robin-eckert/rump/circuit/ibm1394312/bottom_copper.png

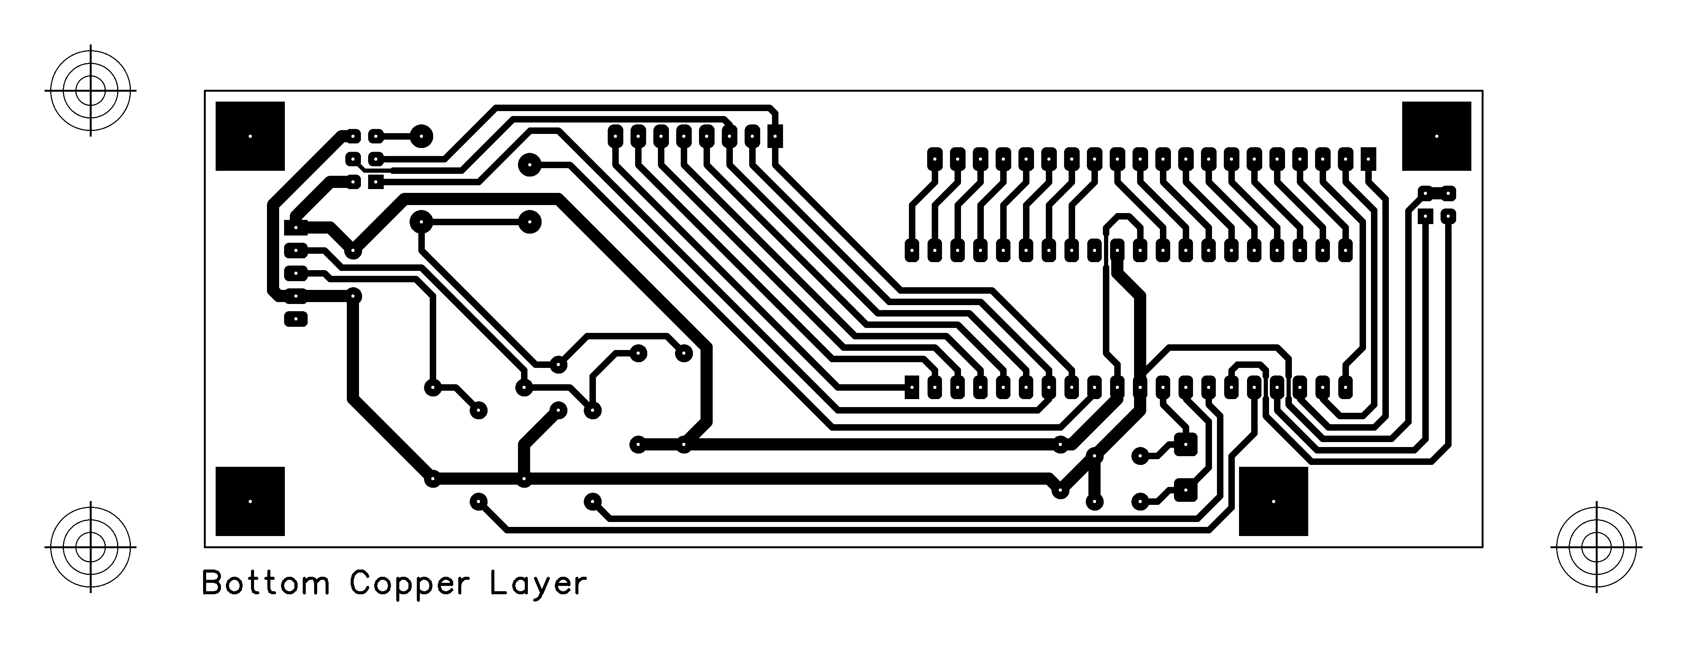
circuit/ibm1394312/bottom_copper.png
