robin-eckert/rump/circuit/ibm1394312/schematic.png

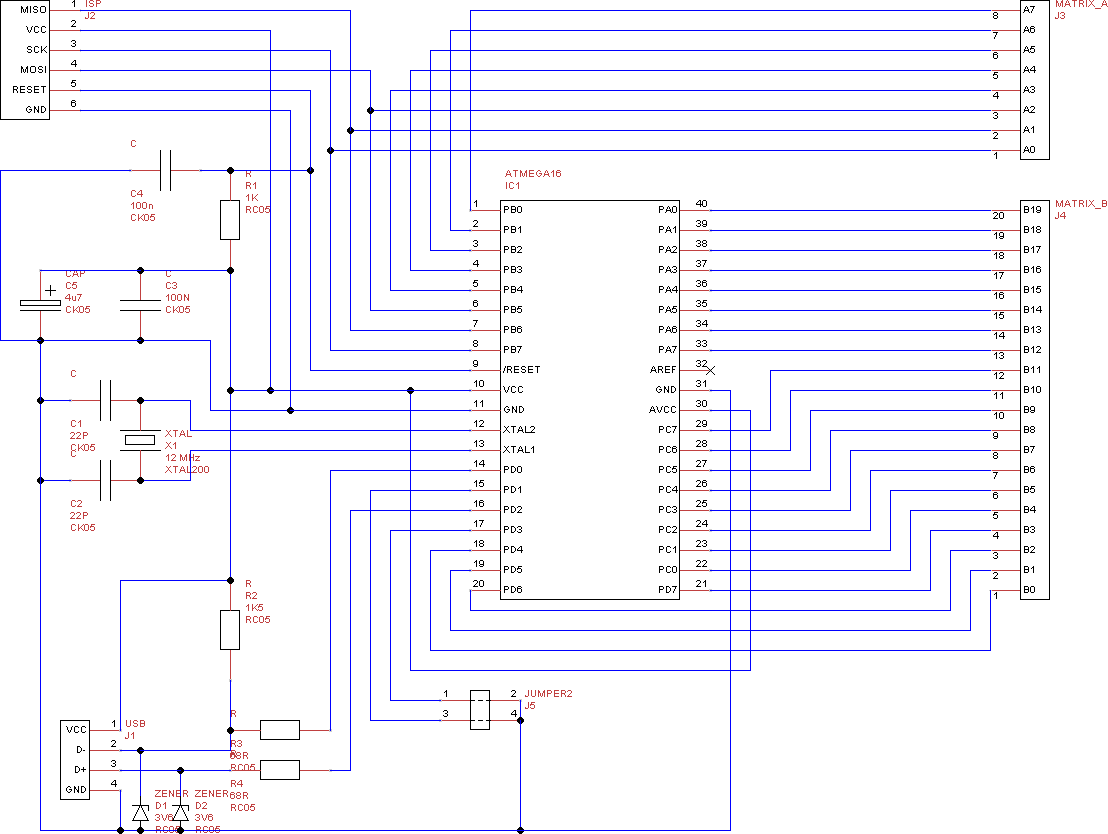
circuit/ibm1394312/schematic.png
