robin-eckert/rump/circuit/ibm1394312/top_copper.png

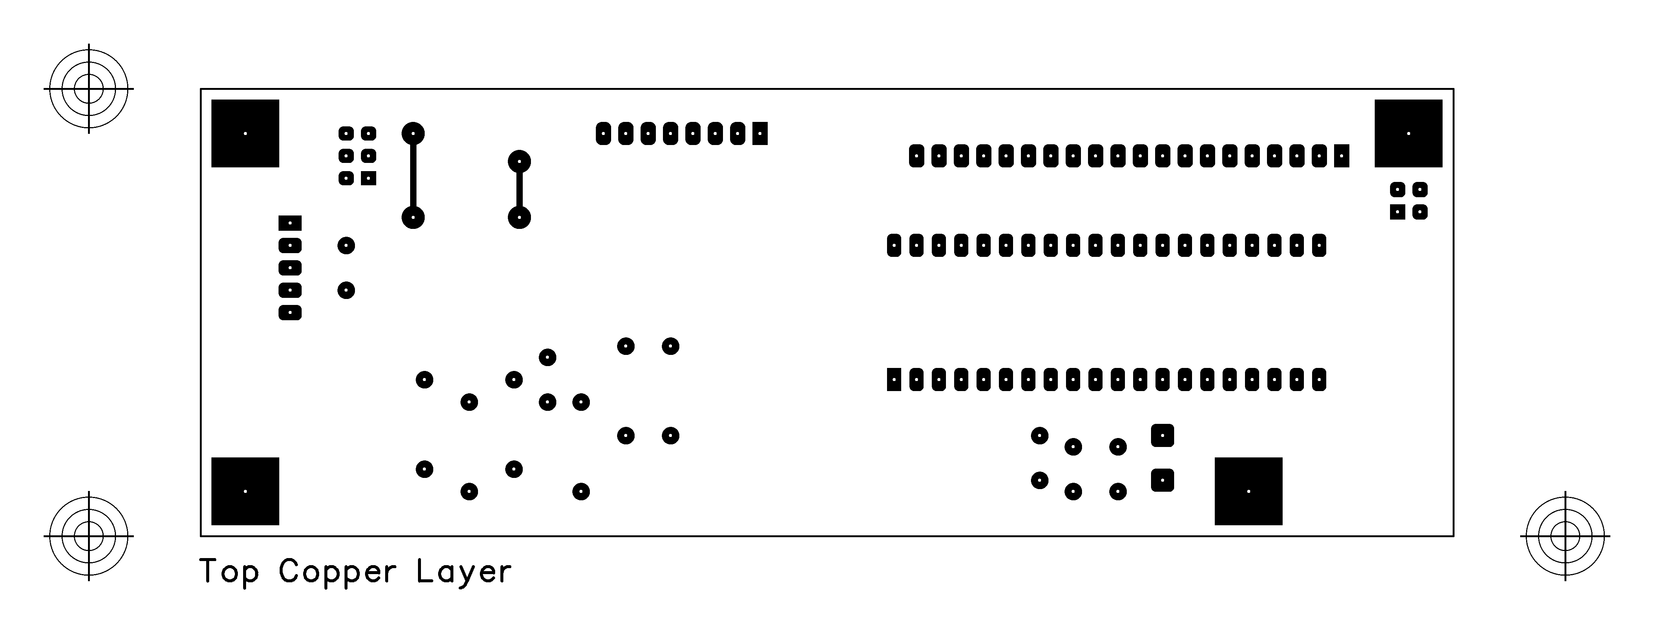
circuit/ibm1394312/top_copper.png
