robin-eckert/rump/circuit/ibm1394312/top_silk.png

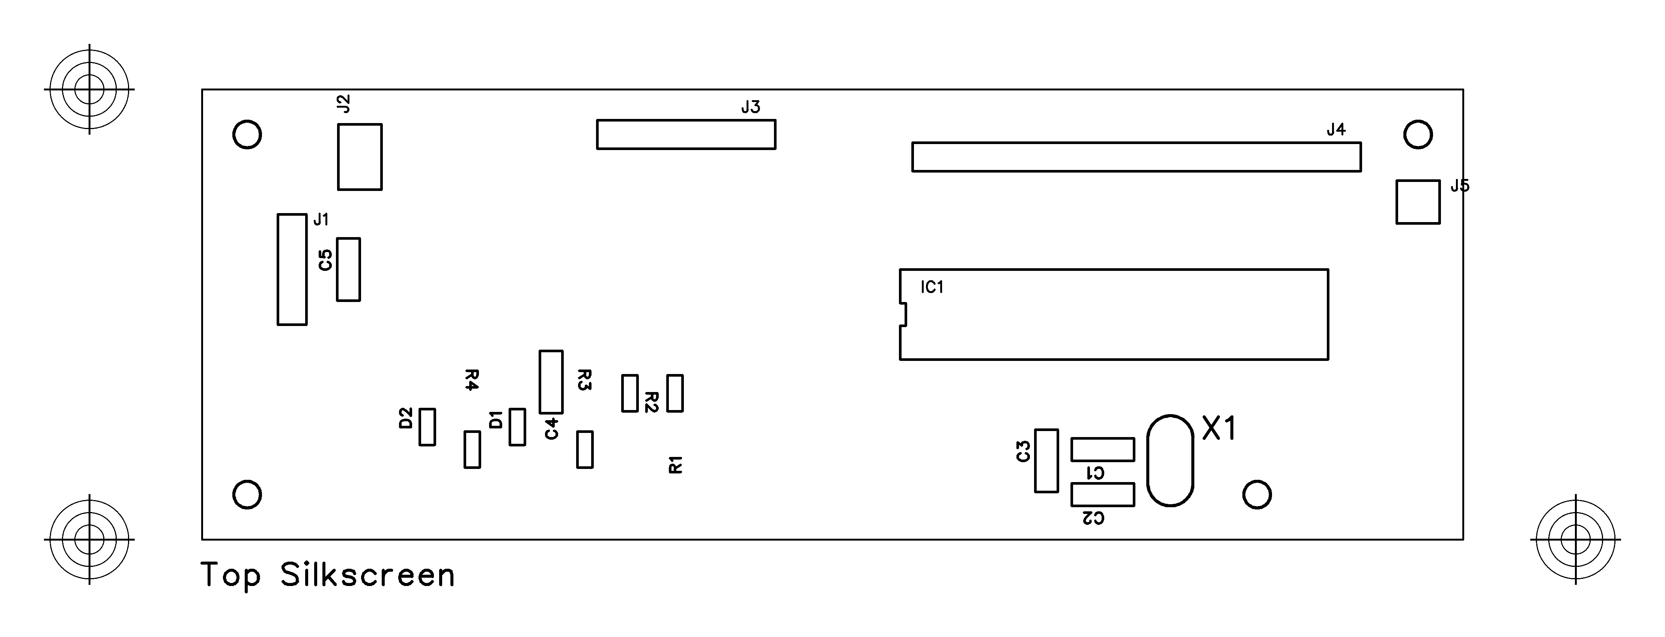
circuit/ibm1394312/top_silk.png
